mohammadrezasafaeian/thermal-bmc/scripts/twi_report.txt

=== TWI DEBUG DUMP REPORT (paste this whole block) ===
dbg_head: NOT PROVIDED
status bytes: 1   frames: 1   ring overflows('!'): 0
RST banners: 0  

-- status histogram --
  0xB3 x1     UNKNOWN CODE

-- frame classification --
  OTHER            x1

-- first 12 frames verbatim --
  [B3]  OTHER

-- auto-verdict (heuristic, confirm with tutor) --
  Mixed/partial pattern - send full report for analysis.
=== END REPORT ===
