mohammadrezasafaeian/thermal-bmc/docs/sim_run_mechanism.png

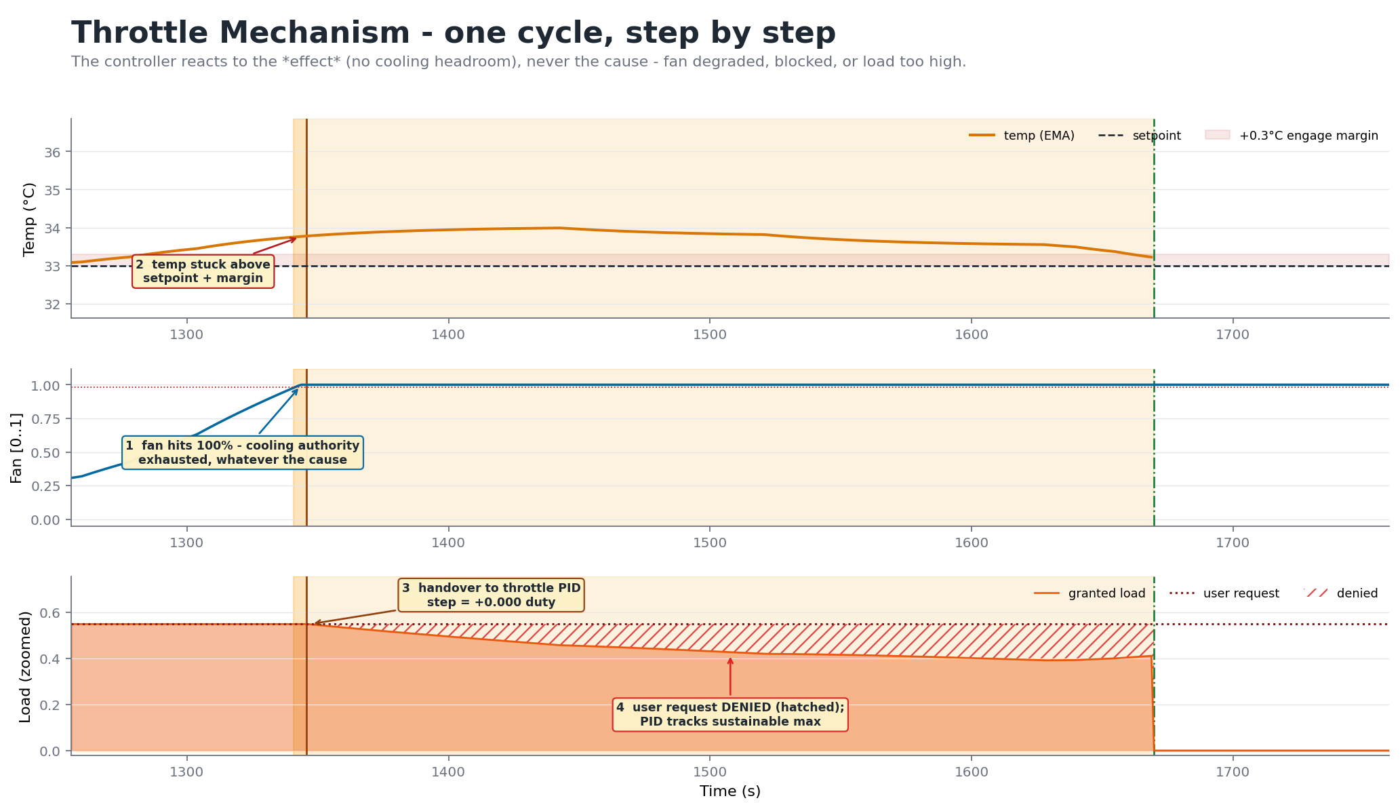
docs/sim_run_mechanism.png
