mohammadrezasafaeian/thermal-bmc/scripts/run1.png

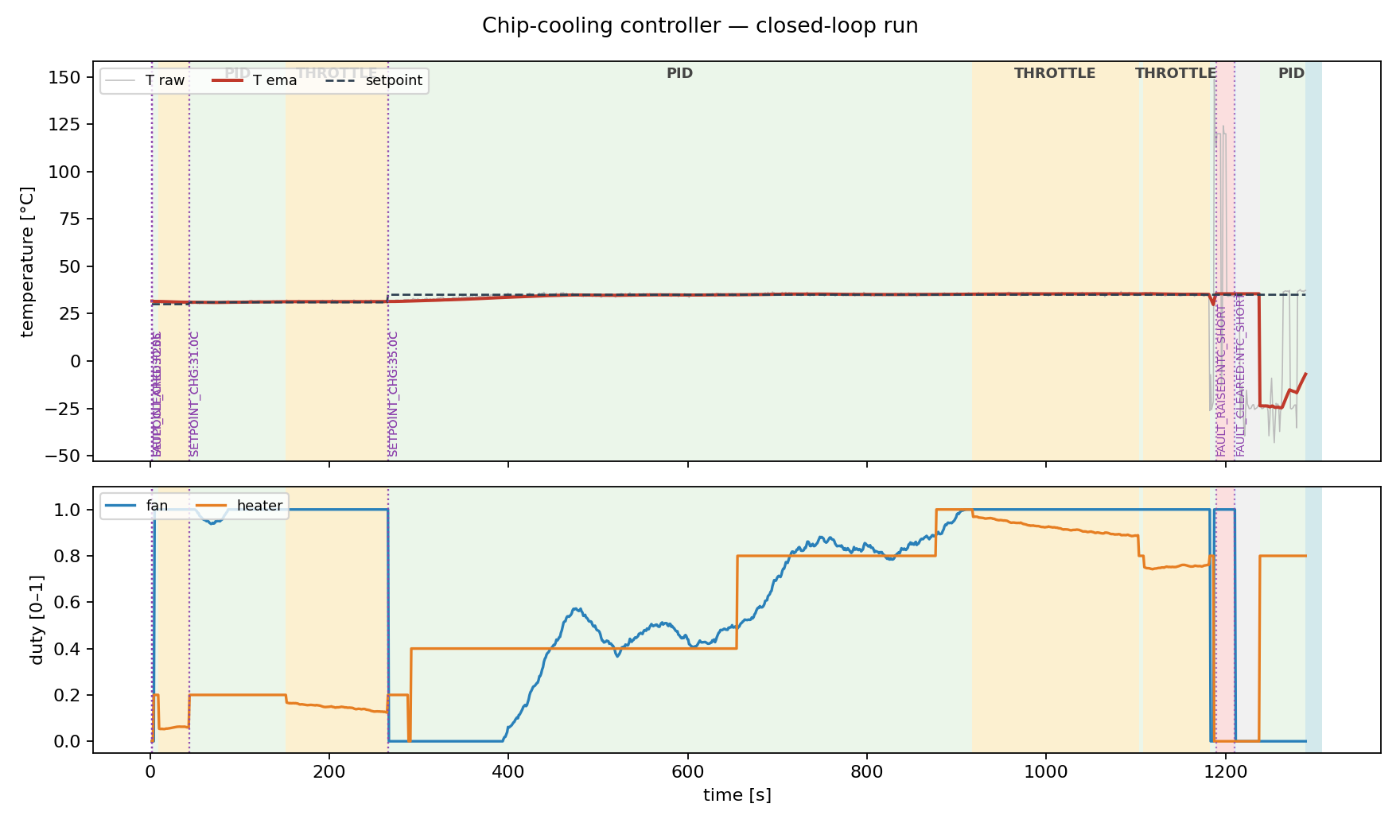
scripts/run1.png
