mohammadrezasafaeian/thermal-bmc/scripts/run1_walkthrough.png

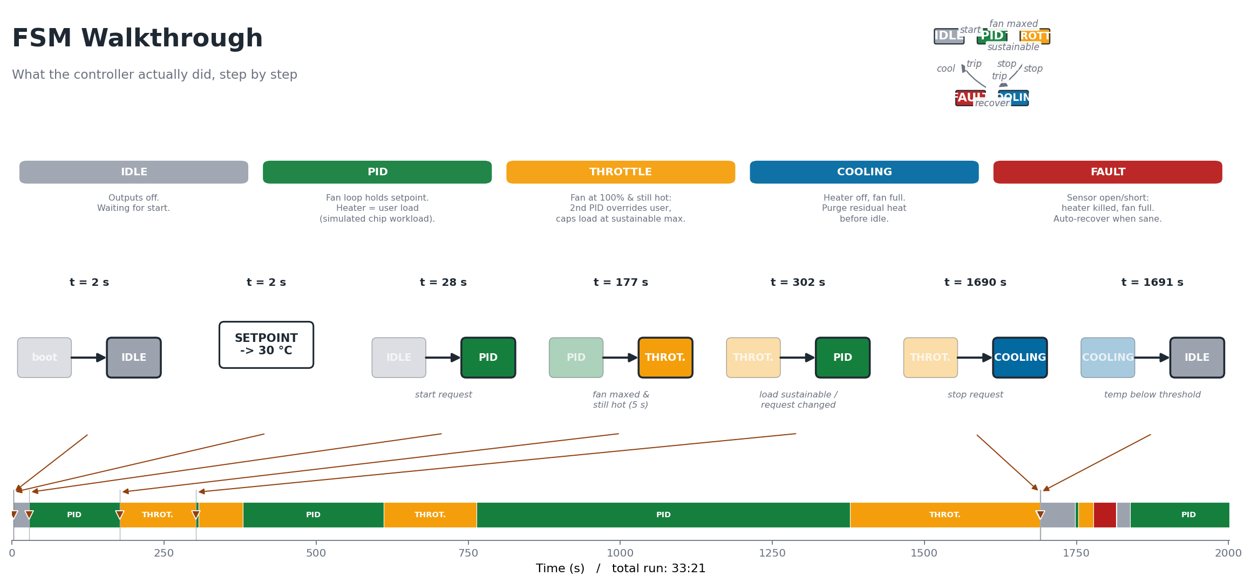
scripts/run1_walkthrough.png
