mohammadrezasafaeian/thermal-bmc/scripts/thermal_bidirectional.png

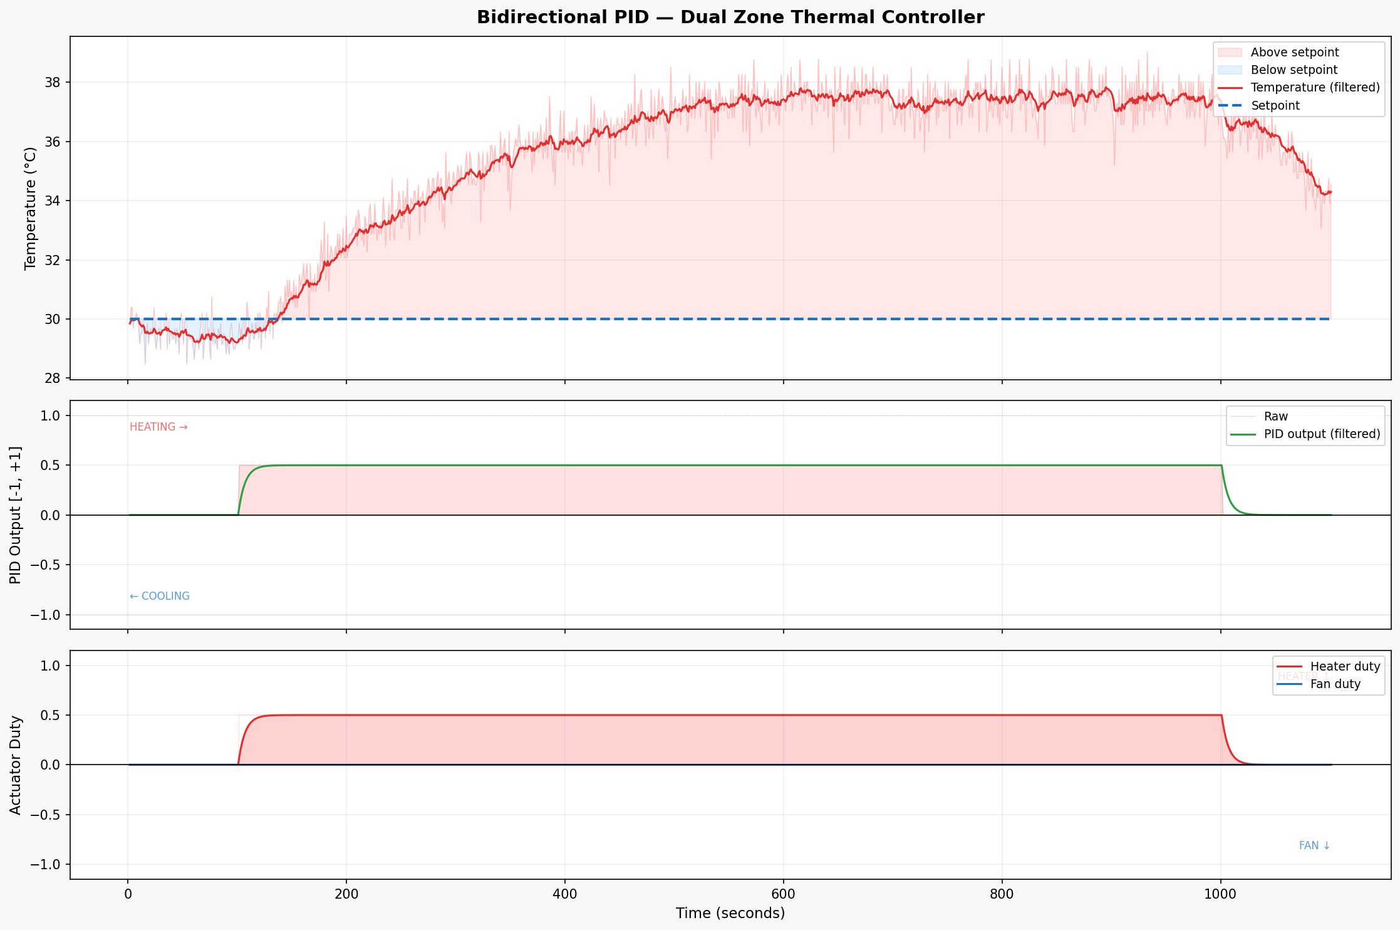
scripts/thermal_bidirectional.png
