mohammadrezasafaeian/thermal-bmc/scripts/step_test_01.txt

Name : thermal_log
	Details:{{time_s = 1.96400011, temp_c = 21.607605, setpoint_c = 30, heater_duty = 0.830414534, fan_duty = 0}, {time_s = 2.97100019, temp_c = 23.1402588, setpoint_c = 30, heater_duty = 0.834197402, fan_duty = 0}, {time_s = 3.97800016, temp_c = 23.8107605, setpoint_c = 30, heater_duty = 0.836668134, 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
	Default:0x20000848 <thermal_log>
	Decimal:536873032
	Hex:0x20000848
	Binary:100000000000000000100001001000
	Octal:04000004110

Name : [0...99]
	Details:{{time_s = 1.96400011, temp_c = 21.607605, setpoint_c = 30, heater_duty = 0.830414534, fan_duty = 0}, {time_s = 2.97100019, temp_c = 23.1402588, setpoint_c = 30, heater_duty = 0.834197402, fan_duty = 0}, {time_s = 3.97800016, temp_c = 23.8107605, setpoint_c = 30, heater_duty = 0.836668134, fan_duty = 0}, {time_s = 4.98500013, temp_c = 23.9472961, setpoint_c = 30, heater_duty = 0.838914156, fan_duty = 0}, {time_s = 5.95400047, temp_c = 24.2227783, setpoint_c = 30, heater_duty = 0.840659082, fan_duty = 0}, {time_s = 6.96100044, temp_c = 24.3618164, setpoint_c = 30, heater_duty = 0.842182279, fan_duty = 0}, {time_s = 7.96900034, temp_c = 24.0846252, setpoint_c = 30, heater_duty = 0.844321847, fan_duty = 0}, {time_s = 8.97700024, temp_c = 22.6177368, setpoint_c = 30, heater_duty = 0.849458754, fan_duty = 0}, {time_s = 9.98500061, temp_c = 22.7472229, setpoint_c = 30, heater_duty = 0.854351103, fan_duty = 0}, {time_s = 10.9550009, temp_c = 23.0084839, setpoint_c = 30, heater_duty = 0.858736992, fan_duty = 0}, {time_s = 11.9630003, temp_c = 23.8107605, setpoint_c = 30, heater_duty = 0.861536026, fan_duty = 0}, {time_s = 12.9720011, temp_c = 24.6424255, setpoint_c = 30, heater_duty = 0.862708151, fan_duty = 0}, {time_s = 13.9810009, temp_c = 23.0084839, setpoint_c = 30, heater_duty = 0.867223501, fan_duty = 0}, {time_s = 14.9900007, temp_c = 22.4889526, setpoint_c = 30, heater_duty = 0.872803688, fan_duty = 0}, {time_s = 15.960001, temp_c = 24.0846252, setpoint_c = 30, heater_duty = 0.875188231, fan_duty = 0}, {time_s = 16.9700012, temp_c = 23.9472961, setpoint_c = 30, heater_duty = 0.877895594, fan_duty = 0}, {time_s = 17.9790001, temp_c = 22.7472229, setpoint_c = 20, heater_duty = -0.120944716, fan_duty = 0}, {time_s = 18.9880009, temp_c = 22.3609314, setpoint_c = 20, heater_duty = -0.122996487, fan_duty = 0.120944716}, {time_s = 19.9590015, temp_c = 22.4889526, setpoint_c = 20, heater_duty = -0.125302047, fan_duty = 0.122996487}, {time_s = 20.9690018, temp_c = 21.361969, setpoint_c = 20, heater_duty = -0.125338316, fan_duty = 0.125302047}, {time_s = 21.9790001, temp_c = 22.2336121, setpoint_c = 20, heater_duty = -0.127145961, fan_duty = 0.125338316}, {time_s = 22.9890003, temp_c = 21.607605, setpoint_c = 20, heater_duty = -0.127696112, fan_duty = 0.127145961}, {time_s = 23.9610004, temp_c = 21.361969, setpoint_c = 20, heater_duty = -0.127767742, fan_duty = 0.127696112}, {time_s = 24.972002, temp_c = 22.6177368, setpoint_c = 20, heater_duty = -0.130381227, fan_duty = 0.127767742}, {time_s = 25.9820004, temp_c = 21.118988, setpoint_c = 20, heater_duty = -0.129974976, fan_duty = 0.130381227}, {time_s = 26.9540005, temp_c = 22.7472229, setpoint_c = 20, heater_duty = -0.132864207, fan_duty = 0.129974976}, {time_s = 27.9660015, temp_c = 21.484436, setpoint_c = 20, heater_duty = -0.133204013, fan_duty = 0.132864207}, {time_s = 28.9770012, temp_c = 22.2336121, setpoint_c = 20, heater_duty = -0.135065109, fan_duty = 0.133204013}, {time_s = 29.9880009, temp_c = 21.361969, setpoint_c = 20, heater_duty = -0.135174438, fan_duty = 0.135065109}, {time_s = 30.9610023, temp_c = 21.855896, setpoint_c = 20, heater_duty = -0.136295095, fan_duty = 0.135174438}, {time_s = 31.9730015, temp_c = 21.9811096, setpoint_c = 23, heater_duty = 0.163525581, fan_duty = 0.136295095}, {time_s = 32.9850006, temp_c = 21.484436, setpoint_c = 23, heater_duty = 0.165539399, fan_duty = 0}, {time_s = 33.9580002, temp_c = 22.4889526, setpoint_c = 23, heater_duty = 0.165520161, fan_duty = 0}, {time_s = 34.9700012, temp_c = 21.607605, setpoint_c = 23, heater_duty = 0.167279243, fan_duty = 0}, {time_s = 35.9830017, temp_c = 21.484436, setpoint_c = 23, heater_duty = 0.169272661, fan_duty = 0}, {time_s = 36.9570007, temp_c = 22.8774719, setpoint_c = 23, heater_duty = 0.168453351, fan_duty = 0}, {time_s = 37.9700012, temp_c = 21.7314148, setpoint_c = 23, heater_duty = 0.16995357, fan_duty = 0}, {time_s = 38.9830017, temp_c = 21.484436, setpoint_c = 23, heater_duty = 0.171940103, fan_duty = 0}, {time_s = 39.9570007, temp_c = 22.6177368, setpoint_c = 23, heater_duty = 0.171635479, fan_duty = 0}, {time_s = 40.9710007, temp_c = 22.4889526, setpoint_c = 23, heater_duty = 0.171601593, fan_duty = 0}, {time_s = 41.9840012, temp_c = 21.484436, setpoint_c = 23, heater_duty = 0.173593611, fan_duty = 0}, {time_s = 42.9590034, temp_c = 21.607605, setpoint_c = 23, heater_duty = 0.175322711, fan_duty = 0}, {time_s = 43.9730034, temp_c = 21.7314148, setpoint_c = 23, heater_duty = 0.176790893, fan_duty = 0}, {time_s = 44.9870033, temp_c = 21.361969, setpoint_c = 23, heater_duty = 0.178991824, fan_duty = 0}, {time_s = 45.9630013, temp_c = 22.3609314, setpoint_c = 23, heater_duty = 0.179169118, fan_duty = 0}, {time_s = 46.9770012, temp_c = 22.3609314, setpoint_c = 23, heater_duty = 0.179353088, fan_duty = 0}, {time_s = 47.9530029, temp_c = 22.4889526, setpoint_c = 23, heater_duty = 0.179286465, fan_duty = 0}, {time_s = 48.9680023, temp_c = 22.8774719, setpoint_c = 23, heater_duty = 0.178449273, fan_duty = 0}, {time_s = 49.9830017, temp_c = 22.2336121, setpoint_c = 23, heater_duty = 0.178923711, fan_duty = 0}, {time_s = 50.9590034, temp_c = 21.361969, setpoint_c = 23, heater_duty = 0.181151196, fan_duty = 0}, {time_s = 51.9750023, temp_c = 21.607605, setpoint_c = 23, heater_duty = 0.18286708, fan_duty = 0}, {time_s = 52.9900017, temp_c = 21.484436, setpoint_c = 23, heater_duty = 0.184818238, fan_duty = 0}, {time_s = 53.9670029, temp_c = 22.2336121, setpoint_c = 23, heater_duty = 0.185250282, fan_duty = 0}, {time_s = 54.9830017, temp_c = 22.7472229, setpoint_c = 23, heater_duty = 0.184654623, fan_duty = 0}, {time_s = 55.9600029, temp_c = 23.1402588, setpoint_c = 23, heater_duty = 0.183285683, fan_duty = 0}, {time_s = 56.9770012, temp_c = 21.7314148, setpoint_c = 23, heater_duty = 0.184770823, fan_duty = 0}, {time_s = 57.9540024, temp_c = 21.484436, setpoint_c = 23, heater_duty = 0.18674247, fan_duty = 0}, {time_s = 58.9710045, temp_c = 22.6177368, setpoint_c = 23, heater_duty = 0.186423331, fan_duty = 0}, {time_s = 59.9880028, temp_c = 21.855896, setpoint_c = 23, heater_duty = 0.187646478, fan_duty = 0}, {time_s = 60.9660034, temp_c = 21.361969, setpoint_c = 23, heater_duty = 0.189855114, fan_duty = 0}, {time_s = 61.9830017, temp_c = 22.7472229, setpoint_c = 23, heater_duty = 0.189264268, fan_duty = 0}, {time_s = 62.9620018, temp_c = 21.9811096, setpoint_c = 23, heater_duty = 0.190227658, fan_duty = 0}, {time_s = 63.9800034, temp_c = 21.484436, setpoint_c = 23, heater_duty = 0.192185342, fan_duty = 0}, {time_s = 64.9580002, temp_c = 22.8774719, setpoint_c = 23, heater_duty = 0.191330999, fan_duty = 0}, {time_s = 65.9760056, temp_c = 21.7314148, setpoint_c = 23, heater_duty = 0.192796856, fan_duty = 0}, {time_s = 66.9560013, temp_c = 22.6177368, setpoint_c = 23, heater_duty = 0.192473978, fan_duty = 0}, {time_s = 67.9570007, temp_c = 22.1070251, setpoint_c = 23, heater_duty = 0.193189308, fan_duty = 0}, {time_s = 68.9580002, temp_c = 21.484436, setpoint_c = 23, heater_duty = 0.195154741, fan_duty = 0}, {time_s = 69.9589996, temp_c = 22.7472229, setpoint_c = 23, heater_duty = 0.194569439, fan_duty = 0}, {time_s = 70.9610062, temp_c = 21.9811096, setpoint_c = 23, heater_duty = 0.195538253, fan_duty = 0}, {time_s = 71.9630051, temp_c = 22.4889526, setpoint_c = 23, heater_duty = 0.195484191, fan_duty = 0}, {time_s = 72.965004, temp_c = 21.855896, setpoint_c = 23, heater_duty = 0.196710497, fan_duty = 0}, {time_s = 73.9670029, temp_c = 22.2336121, setpoint_c = 23, heater_duty = 0.197172254, fan_duty = 0}, {time_s = 74.9690018, temp_c = 22.6177368, setpoint_c = 23, heater_duty = 0.196865618, fan_duty = 0}, {time_s = 75.9710007, temp_c = 21.855896, setpoint_c = 23, heater_duty = 0.198101044, fan_duty = 0}, {time_s = 76.9740067, temp_c = 23.0084839, setpoint_c = 23, heater_duty = 0.197015733, fan_duty = 0}, {time_s = 77.977005, temp_c = 21.7314148, setpoint_c = 23, heater_duty = 0.198516309, fan_duty = 0}, {time_s = 78.9800034, temp_c = 22.8774719, setpoint_c = 23, heater_duty = 0.197705805, fan_duty = 0}, {time_s = 79.9830017, temp_c = 21.607605, setpoint_c = 23, heater_duty = 0.199463487, fan_duty = 0}, {time_s = 80.9870071, temp_c = 22.8774719, setpoint_c = 23, heater_duty = 0.198658288, fan_duty = 0}, {time_s = 81.9520035, temp_c = 21.7314148, setpoint_c = 23, heater_duty = 0.200172424, fan_duty = 0}, {time_s = 82.9560013, temp_c = 23.5401611, setpoint_c = 23, heater_duty = 0.198044747, fan_duty = 0}, {time_s = 83.9600067, temp_c = 21.607605, setpoint_c = 23, heater_duty = 0.199831426, fan_duty = 0}, {time_s = 84.9640045, temp_c = 21.7314148, setpoint_c = 23, heater_duty = 0.201356038, fan_duty = 0}, {time_s = 85.9680023, temp_c = 22.6177368, setpoint_c = 23, heater_duty = 0.201090783, fan_duty = 0}, {time_s = 86.9730072, temp_c = 21.855896, setpoint_c = 23, heater_duty = 0.202366799, fan_duty = 0}, {time_s = 87.9780045, temp_c = 22.7472229, setpoint_c = 23, heater_duty = 0.20184578, fan_duty = 0}, {time_s = 88.9830017, temp_c = 21.9811096, setpoint_c = 23, heater_duty = 0.202877611, fan_duty = 0}, {time_s = 89.9880066, temp_c = 21.855896, setpoint_c = 23, heater_duty = 0.204156488, fan_duty = 0}, {time_s = 90.9540024, temp_c = 22.4889526, setpoint_c = 23, heater_duty = 0.204156935, fan_duty = 0}, {time_s = 91.9600067, temp_c = 23.0084839, setpoint_c = 23, heater_duty = 0.203122303, fan_duty = 0}, {time_s = 92.965004, temp_c = 21.361969, setpoint_c = 23, heater_duty = 0.20541434, fan_duty = 0}, {time_s = 93.9710007, temp_c = 21.855896, setpoint_c = 23, heater_duty = 0.206695065, fan_duty = 0}, {time_s = 94.977005, temp_c = 22.4889526, setpoint_c = 23, heater_duty = 0.206697211, fan_duty = 0}, {time_s = 95.9830017, temp_c = 22.7472229, setpoint_c = 23, heater_duty = 0.206188992, fan_duty = 0}, {time_s = 96.989006, temp_c = 22.2336121, setpoint_c = 23, heater_duty = 0.206726313, fan_duty = 0}, {time_s = 97.9570084, temp_c = 21.607605, setpoint_c = 23, heater_duty = 0.208522141, fan_duty = 0}, {time_s = 98.9630051, temp_c = 21.7314148, setpoint_c = 23, heater_duty = 0.210055619, fan_duty = 0}, {time_s = 99.9700012, temp_c = 21.9811096, setpoint_c = 23, heater_duty = 0.211077392, fan_duty = 0}, {time_s = 100.977005, temp_c = 21.855896, setpoint_c = 23, heater_duty = 0.212346464, fan_duty = 0}}
	Default:0x20000848 <thermal_log>
	Decimal:536873032
	Hex:0x20000848
	Binary:100000000000000000100001001000
	Octal:04000004110

Name : [600...699]
	Details:{{time_s = 601.980042, temp_c = 32.0738831, setpoint_c = 30, heater_duty = 0.691611528, fan_duty = 0}, {time_s = 602.968018, temp_c = 29.8485107, setpoint_c = 30, heater_duty = 0.692763627, fan_duty = 0}, {time_s = 603.957031, temp_c = 30.385376, setpoint_c = 30, heater_duty = 0.692816973, 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
	Default:0x20003728 <thermal_log+12000>
	Decimal:536885032
	Hex:0x20003728
	Binary:100000000000000011011100101000
	Octal:04000033450

Name : [100...199]
	Details:{{time_s = 101.984001, temp_c = 22.4889526, setpoint_c = 23, heater_duty = 0.212337375, fan_duty = 0}, {time_s = 102.952003, temp_c = 22.2336121, setpoint_c = 23, heater_duty = 0.212849349, fan_duty = 0}, {time_s = 103.960007, temp_c = 22.1070251, setpoint_c = 23, heater_duty = 0.213617563,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
	Default:0x20001018 <thermal_log+2000>
	Decimal:536875032
	Hex:0x20001018
	Binary:100000000000000001000000011000
	Octal:04000010030

Name : [300...399]
	Details:{{time_s = 301.971008, temp_c = 25.5055237, setpoint_c = 30, heater_duty = 0.999126792, fan_duty = 0}, {time_s = 302.959015, temp_c = 25.5055237, setpoint_c = 30, heater_duty = 1, fan_duty = 0}, {time_s = 303.987, temp_c = 26.7093811, setpoint_c = 30, heater_duty = 0.996566057, fan_duty = 0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
	Default:0x20001fb8 <thermal_log+6000>
	Decimal:536879032
	Hex:0x20001fb8
	Binary:100000000000000001111110111000
	Octal:04000017670

Name : [200...299]
	Details:{{time_s = 201.972015, temp_c = 22.4889526, setpoint_c = 23, heater_duty = 0.215622678, fan_duty = 0}, {time_s = 202.961014, temp_c = 23.1402588, setpoint_c = 23, heater_duty = 0.214917526, fan_duty = 0}, {time_s = 203.990005, temp_c = 23.5401611, setpoint_c = 23, heater_duty = 0.213421121,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
	Default:0x200017e8 <thermal_log+4000>
	Decimal:536877032
	Hex:0x200017e8
	Binary:100000000000000001011111101000
	Octal:04000013750

Name : [400...499]
	Details:{{time_s = 401.966034, temp_c = 28.4746094, setpoint_c = 30, heater_duty = 0.940233052, fan_duty = 0}, {time_s = 402.95401, temp_c = 30.385376, setpoint_c = 30, heater_duty = 0.936831951, fan_duty = 0}, {time_s = 403.981018, temp_c = 28.8105469, setpoint_c = 30, heater_duty = 0.936655104, f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
	Default:0x20002788 <thermal_log+8000>
	Decimal:536881032
	Hex:0x20002788
	Binary:100000000000000010011110001000
	Octal:04000023610

Name : [500...599]
	Details:{{time_s = 501.97403, temp_c = 30.2050476, setpoint_c = 30, heater_duty = 0.801114559, fan_duty = 0}, {time_s = 502.962036, temp_c = 30.2050476, setpoint_c = 30, heater_duty = 0.800677776, fan_duty = 0}, {time_s = 503.989014, temp_c = 31.8801575, setpoint_c = 30, heater_duty = 0.796882629, 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
	Default:0x20002f58 <thermal_log+10000>
	Decimal:536883032
	Hex:0x20002f58
	Binary:100000000000000010111101011000
	Octal:04000027530

Name : [700...799]
	Details:{{time_s = 701.983032, temp_c = 30.2050476, setpoint_c = 30, heater_duty = 0.647999525, fan_duty = 0}, {time_s = 702.955017, temp_c = 29.323761, setpoint_c = 30, heater_duty = 0.650060594, fan_duty = 0}, {time_s = 703.966003, temp_c = 30.2050476, setpoint_c = 30, heater_duty = 0.650321662, 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
	Default:0x20003ef8 <thermal_log+14000>
	Decimal:536887032
	Hex:0x20003ef8
	Binary:100000000000000011111011111000
	Octal:04000037370

Name : [800...899]
	Details:{{time_s = 800.221008, temp_c = 29.6723022, setpoint_c = 30, heater_duty = 0.647840202, fan_duty = 0}, {time_s = 801.232056, temp_c = 30.2050476, setpoint_c = 30, heater_duty = 0.647747219, fan_duty = 0}, {time_s = 802.203064, temp_c = 28.8105469, setpoint_c = 30, heater_duty = 0.650453091,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
	Default:0x200046c8 <thermal_log+16000>
	Decimal:536889032
	Hex:0x200046c8
	Binary:100000000000000100011011001000
	Octal:04000043310

Name : [900...999]
	Details:{{time_s = 900.21405, temp_c = 29.1514282, setpoint_c = 30, heater_duty = 0.655790687, fan_duty = 0}, {time_s = 901.225037, temp_c = 30.2050476, setpoint_c = 30, heater_duty = 0.655443847, fan_duty = 0}, {time_s = 902.197021, temp_c = 29.323761, setpoint_c = 30, heater_duty = 0.656870186, f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
	Default:0x20004e98 <thermal_log+18000>
	Decimal:536891032
	Hex:0x20004e98
	Binary:100000000000000100111010011000
	Octal:04000047230
