mohammadrezasafaeian/thermal-bmc/scripts/step_test_01.png

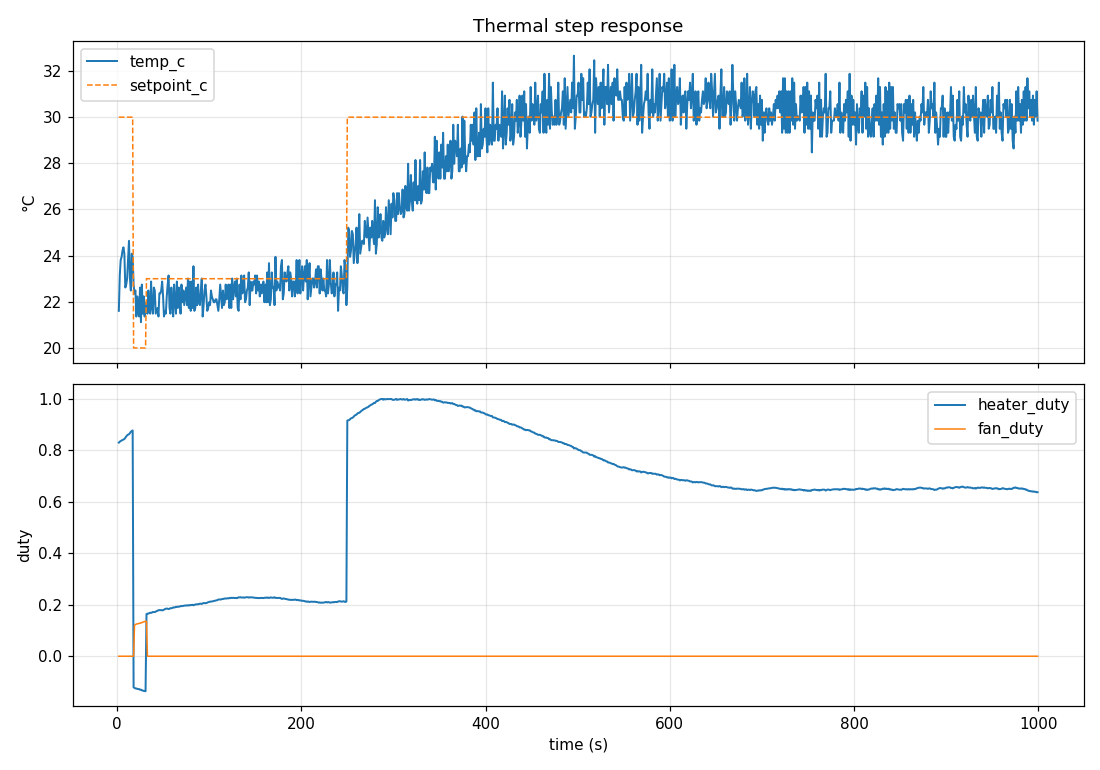
scripts/step_test_01.png
