mohammadrezasafaeian/thermal-bmc/scripts/step_test_01_pid.png

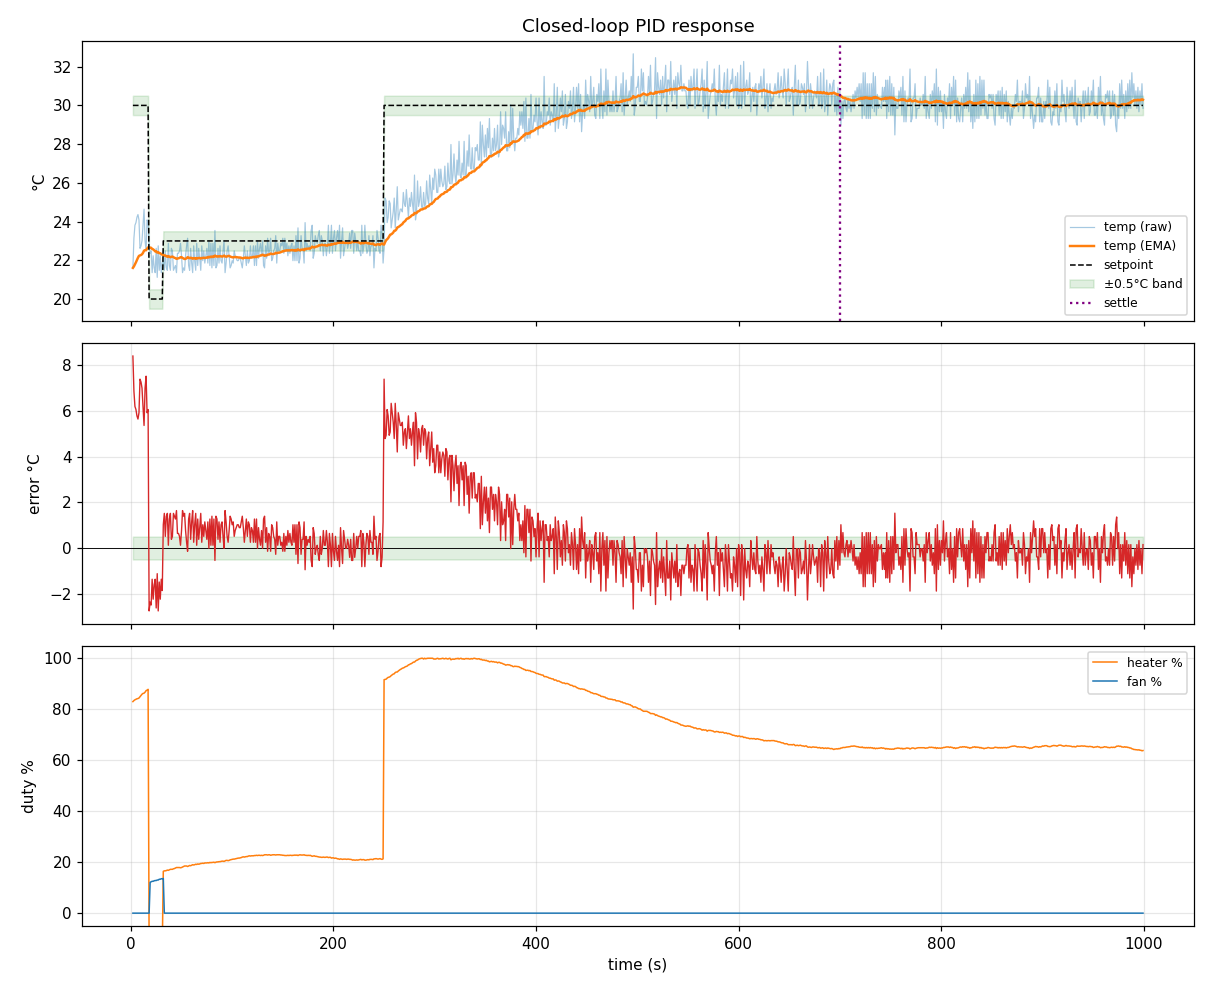
scripts/step_test_01_pid.png
