mohammadrezasafaeian/thermal-bmc/Core/Src/main.c

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
/* Includes ------------------------------------------------------------------*/
#include "main.h"
#include "cmsis_os.h"

/* USER CODE BEGIN Includes */
#include "ssd1306.h"
#include "thermal_app.h"
#include "cyc.h"
#include "FreeRTOS.h"
/* USER CODE END Includes */

ADC_HandleTypeDef hadc1;

I2C_HandleTypeDef hi2c1;

TIM_HandleTypeDef htim2;
TIM_HandleTypeDef htim3;
TIM_HandleTypeDef htim5;

UART_HandleTypeDef huart1;
UART_HandleTypeDef huart2;

osThreadId defaultTaskHandle;
/* USER CODE BEGIN PV */
extern volatile Profiler g_prof;

#define DBG_RING_SZ 256
volatile uint8_t  dbg_ring[DBG_RING_SZ];
volatile uint16_t dbg_head = 0;        /* watch these two in Live     */
uint8_t           dbg_rx_byte;         /* Expressions / Live Watch
/* USER CODE END PV */

void SystemClock_Config(void);
static void MX_GPIO_Init(void);
static void MX_USART2_UART_Init(void);
static void MX_I2C1_Init(void);
static void MX_ADC1_Init(void);
static void MX_TIM2_Init(void);
static void MX_TIM3_Init(void);
static void MX_TIM5_Init(void);
static void MX_USART1_UART_Init(void);
void StartDefaultTask(void const * argument);

/* USER CODE BEGIN 0 */

volatile uint32_t g_tach_pulses = 0;
/* USER CODE END 0 */

/**
  * @brief  The application entry point.
  * @retval int
  */
int main(void)
{

  /* MCU Configuration--------------------------------------------------------*/

  /* Reset of all peripherals, Initializes the Flash interface and the Systick. */
  HAL_Init();

  /* Configure the system clock */
  SystemClock_Config();

  /* Initialize all configured peripherals */
  MX_GPIO_Init();
  MX_USART2_UART_Init();
  MX_I2C1_Init();
  MX_ADC1_Init();
  MX_TIM2_Init();
  MX_TIM3_Init();
  MX_TIM5_Init();
  MX_USART1_UART_Init();
  HAL_UART_Receive_IT(&huart1, &dbg_rx_byte, 1);
  /* USER CODE BEGIN 2 */

  ssd1306_init();     /* Initialise OLED driver                          */
  ThermalApp_Init();  /* Start PWM, zero buffers, display splash screen  */
  /* USER CODE END 2 */

  /* USER CODE BEGIN RTOS_MUTEX */
  /* add mutexes, ... */
  /* USER CODE END RTOS_MUTEX */

  /* USER CODE BEGIN RTOS_SEMAPHORES */
  /* add semaphores, ... */
  /* USER CODE END RTOS_SEMAPHORES */

  /* USER CODE BEGIN RTOS_TIMERS */
  /* start timers, add new ones, ... */
  /* USER CODE END RTOS_TIMERS */

  /* USER CODE BEGIN RTOS_QUEUES */
  /* add queues, ... */
  /* USER CODE END RTOS_QUEUES */

  /* Create the thread(s) */
  /* definition and creation of defaultTask */
  osThreadDef(defaultTask, StartDefaultTask, osPriorityNormal, 0, 512);
  defaultTaskHandle = osThreadCreate(osThread(defaultTask), NULL);

  /* USER CODE BEGIN RTOS_THREADS */

  ThermalApp_StartTasks();
  /* USER CODE END RTOS_THREADS */

  /* Start scheduler */
  osKernelStart();

  /* We should never get here as control is now taken by the scheduler */

  /* Infinite loop */
  /* USER CODE BEGIN WHILE */
  while (1)
  {
    /* USER CODE END WHILE */

    /* USER CODE BEGIN 3 */

  }
  /* USER CODE END 3 */
}

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
/* USER CODE BEGIN 4 */
/*
 * NOTE: HAL_TIM_PeriodElapsedCallback intentionally NOT defined here.
 * The single dispatcher lives in the CubeMX-generated callback below;
 * our TIM2 branch is inside its USER CODE Callback 1 section so it
 * survives code regeneration. A second definition here = link error.
 */
void HAL_GPIO_EXTI_Callback(uint16_t GPIO_Pin)
{
    if (GPIO_Pin == GPIO_PIN_9) {
        g_tach_pulses++;
    }
}

void HAL_UART_RxCpltCallback(UART_HandleTypeDef *huart)
{
    if (huart->Instance == USART1) {
        dbg_ring[dbg_head % DBG_RING_SZ] = dbg_rx_byte;
        dbg_head++;
        HAL_UART_Receive_IT(&huart1, &dbg_rx_byte, 1);
    }
}
/* USER CODE END 4 */

/* USER CODE BEGIN Header_StartDefaultTask */
/**
  * @brief  Function implementing the defaultTask thread.
  * @param  argument: Not used
  * @retval None
  */
/* USER CODE END Header_StartDefaultTask */
void StartDefaultTask(void const * argument)
{
  /* USER CODE BEGIN 5 */
  /* Infinite loop */
  for(;;)
  {
    osDelay(1);
  }
  /* USER CODE END 5 */
}

/**
  * @brief  Period elapsed callback in non blocking mode
  * @note   This function is called  when TIM11 interrupt took place, inside
  * HAL_TIM_IRQHandler(). It makes a direct call to HAL_IncTick() to increment
  * a global variable "uwTick" used as application time base.
  * @param  htim : TIM handle
  * @retval None
  */
void HAL_TIM_PeriodElapsedCallback(TIM_HandleTypeDef *htim)
{
  if (htim->Instance == TIM11)
  {
    HAL_IncTick();
  }
  /* USER CODE BEGIN Callback 1 */
  else if (htim->Instance == TIM2) {   /* 1 Hz control tick -> queue event */
    ThermalApp_TickISR();
  }
  /* USER CODE END Callback 1 */
}

/**
  * @brief  This function is executed in case of error occurrence.
  * @retval None
  */
void Error_Handler(void)
{
  /* USER CODE BEGIN Error_Handler_Debug */
  __disable_irq();
  while (1)
  {
    /* Spin here; attach a debugger and inspect the call stack. */
  }
  /* USER CODE END Error_Handler_Debug */
}
#ifdef USE_FULL_ASSERT
/**
  * @brief  Reports the name of the source file and the source line number
  *         where the assert_param error has occurred.
  * @param  file: pointer to the source file name
  * @param  line: assert_param error line source number
  * @retval None
  */
void assert_failed(uint8_t *file, uint32_t line)
{
  /* USER CODE BEGIN 6 */
  /* Example: printf("Wrong parameter: file %s, line %d\r\n", file, line); */
  (void)file;
  (void)line;
  /* USER CODE END 6 */
}
#endif /* USE_FULL_ASSERT */
