mohammadrezasafaeian/thermal-bmc/Thermistor.ioc

Mcu.UserName=STM32F411CEUx
PA0-WKUP.Signal=ADCx_IN0
PA1.Signal=S_TIM5_CH2
PA10.Signal=USART1_RX
PA2.Signal=USART2_TX
PA3.Signal=USART2_RX
PA4.Signal=GPIO_Output
PA5.Signal=GPIO_Output
PA6.Signal=S_TIM3_CH1
PA7.Signal=S_TIM3_CH2
PA9.Signal=USART1_TX
PB12.Signal=GPIO_Output
PB4.Signal=GPIO_Output
PB6.Signal=I2C1_SCL
PB7.Signal=I2C1_SDA
PB8.Signal=GPIO_Output
PB9.Signal=GPXTI9
