mohammadrezasafaeian/thermal-bmc/scripts/thermal_dump.txt

Name : thermal_log
	Details:{{time_s = 1.96400011, temp_c = 29.8485107, setpoint_c = 30, heater_duty = 0, fan_duty = 0}, {time_s = 2.9690001, temp_c = 30.385376, setpoint_c = 30, heater_duty = 0, fan_duty = 0}, {time_s = 3.97500014, temp_c = 30.385376, setpoint_c = 30, heater_duty = 0, fan_duty = 0}, {time_s = 4.98200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
	Default:0x20000848 <thermal_log>
	Decimal:536873032
	Hex:0x20000848
	Binary:100000000000000000100001001000
	Octal:04000004110

Name : [400...499]
	Details:{{time_s = 401.956024, temp_c = 36.0915527, setpoint_c = 30, heater_duty = 0.5, fan_duty = 0}, {time_s = 402.984009, temp_c = 35.4104309, setpoint_c = 30, heater_duty = 0.5, fan_duty = 0}, {time_s = 403.973022, temp_c = 36.322998, setpoint_c = 30, heater_duty = 0.5, fan_duty = 0}, {time_s =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
	Default:0x20002788 <thermal_log+8000>
	Decimal:536881032
	Hex:0x20002788
	Binary:100000000000000010011110001000
	Octal:04000023610

Name : [0...99]
	Details:{{time_s = 1.96400011, temp_c = 29.8485107, setpoint_c = 30, heater_duty = 0, fan_duty = 0}, {time_s = 2.9690001, temp_c = 30.385376, setpoint_c = 30, heater_duty = 0, fan_duty = 0}, {time_s = 3.97500014, temp_c = 30.385376, setpoint_c = 30, heater_duty = 0, fan_duty = 0}, {time_s = 4.98200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
	Default:0x20000848 <thermal_log>
	Decimal:536873032
	Hex:0x20000848
	Binary:100000000000000000100001001000
	Octal:04000004110

Name : [100...199]
	Details:{{time_s = 101.977005, temp_c = 29.8485107, setpoint_c = 30, heater_duty = 0.5, fan_duty = 0}, {time_s = 102.983002, temp_c = 29.323761, setpoint_c = 30, heater_duty = 0.5, fan_duty = 0}, {time_s = 103.990005, temp_c = 29.6723022, setpoint_c = 30, heater_duty = 0.5, fan_duty = 0}, {time_s =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
	Default:0x20001018 <thermal_log+2000>
	Decimal:536875032
	Hex:0x20001018
	Binary:100000000000000001000000011000
	Octal:04000010030

Name : [200...299]
	Details:{{time_s = 201.983017, temp_c = 32.466156, setpoint_c = 30, heater_duty = 0.5, fan_duty = 0}, {time_s = 202.972015, temp_c = 32.8650818, setpoint_c = 30, heater_duty = 0.5, fan_duty = 0}, {time_s = 203.960007, temp_c = 32.8650818, setpoint_c = 30, heater_duty = 0.5, fan_duty = 0}, {time_s =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
	Default:0x200017e8 <thermal_log+4000>
	Decimal:536877032
	Hex:0x200017e8
	Binary:100000000000000001011111101000
	Octal:04000013750

Name : [300...399]
	Details:{{time_s = 301.962006, temp_c = 35.1876221, setpoint_c = 30, heater_duty = 0.5, fan_duty = 0}, {time_s = 302.990021, temp_c = 34.9668579, setpoint_c = 30, heater_duty = 0.5, fan_duty = 0}, {time_s = 303.979004, temp_c = 34.5314026, setpoint_c = 30, heater_duty = 0.5, fan_duty = 0}, {time_s 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
	Default:0x20001fb8 <thermal_log+6000>
	Decimal:536879032
	Hex:0x20001fb8
	Binary:100000000000000001111110111000
	Octal:04000017670

Name : [500...599]
	Details:{{time_s = 501.988037, temp_c = 37.0308838, setpoint_c = 30, heater_duty = 0.5, fan_duty = 0}, {time_s = 502.97702, temp_c = 36.7926025, setpoint_c = 30, heater_duty = 0.5, fan_duty = 0}, {time_s = 503.965027, temp_c = 37.2715454, setpoint_c = 30, heater_duty = 0.5, fan_duty = 0}, {time_s =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
	Default:0x20002f58 <thermal_log+10000>
	Decimal:536883032
	Hex:0x20002f58
	Binary:100000000000000010111101011000
	Octal:04000027530

Name : [600...699]
	Details:{{time_s = 601.972046, temp_c = 37.0308838, setpoint_c = 30, heater_duty = 0.5, fan_duty = 0}, {time_s = 602.960022, temp_c = 37.7601929, setpoint_c = 30, heater_duty = 0.5, fan_duty = 0}, {time_s = 603.988037, temp_c = 38.2589111, setpoint_c = 30, heater_duty = 0.5, fan_duty = 0}, {time_s 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
	Default:0x20003728 <thermal_log+12000>
	Decimal:536885032
	Hex:0x20003728
	Binary:100000000000000011011100101000
	Octal:04000033450

Name : [700...799]
	Details:{{time_s = 701.960022, temp_c = 36.5566406, setpoint_c = 30, heater_duty = 0.5, fan_duty = 0}, {time_s = 702.988037, temp_c = 37.2715454, setpoint_c = 30, heater_duty = 0.5, fan_duty = 0}, {time_s = 703.976013, temp_c = 36.7926025, setpoint_c = 30, heater_duty = 0.5, fan_duty = 0}, {time_s 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
	Default:0x20003ef8 <thermal_log+14000>
	Decimal:536887032
	Hex:0x20003ef8
	Binary:100000000000000011111011111000
	Octal:04000037370

Name : [800...899]
	Details:{{time_s = 801.968018, temp_c = 38.0082397, setpoint_c = 30, heater_duty = 0.5, fan_duty = 0}, {time_s = 802.979065, temp_c = 37.2715454, setpoint_c = 30, heater_duty = 0.5, fan_duty = 0}, {time_s = 803.990051, temp_c = 36.7926025, setpoint_c = 30, heater_duty = 0.5, fan_duty = 0}, {time_s 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
	Default:0x200046c8 <thermal_log+16000>
	Decimal:536889032
	Hex:0x200046c8
	Binary:100000000000000100011011001000
	Octal:04000043310

Name : [900...999]
	Details:{{time_s = 901.987061, temp_c = 36.5566406, setpoint_c = 30, heater_duty = 0.5, fan_duty = 0}, {time_s = 902.958069, temp_c = 35.1876221, setpoint_c = 30, heater_duty = 0.5, fan_duty = 0}, {time_s = 903.969055, temp_c = 36.7926025, setpoint_c = 30, heater_duty = 0.5, fan_duty = 0}, {time_s 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
	Default:0x20004e98 <thermal_log+18000>
	Decimal:536891032
	Hex:0x20004e98
	Binary:100000000000000100111010011000
	Octal:04000047230
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
