mohammadrezasafaeian/thermal-bmc/(commit log)

2026-05-28 feat: thermal controller with dual-PWM, EMA pre-filter, event-driven loop
2026-05-28 feat: bidirectional PID, output [-1,+1], heater/fan split
2026-05-28 feat: add Python analysis script with thermal dump parser
    [thermal_dump.txt]
2026-05-31 add FOPDT/SIMC extractor + fingerprint parser; plant ID K~17 tau~111 theta~10 -> Kp~0.11 Ki~0.0008
2026-06-01 closed-loop PID verified (Kp=0.10 Ki=0.0008); overshoot 11% matches phase-margin prediction; add response analyzer
2026-06-02 Rebuild ZoneCtrl FSM (IDLE/PID/COOLING done); voltage-based fault detect + debounce; ST_FAULT pending
2026-06-02 chore(scripts): remove obsolete plotter; add step-test capture artifacts
    [step_test.csv, step_test_01.csv, thermal_dump.txt]
2026-06-03 fix(thermal): freeze EMA outside PID state; clean boot event init
    [thermal_app.c, thermal_app.h]
2026-06-04 test(thermal): verified black-box log survives warm reset; cold-boot via magic mismatch confirmed
    [thermal_app.c]
2026-06-11 Phase 0: DWT profiling + hand-verified ring buffer rewrite
    - cyc.h: DWT_CYCCNT profiler (g_prof) - tick latency, ADC/OLED/ctrl costs in us
    - Baseline measured: ctrl work 91us; latency 5us..39.6ms (OLED+ADC collision)
    - ring_buf: SPSC rewrite - wrap-safe IsFull, store-before-publish ordering
    rationale documented, boot self-test
    - thermal_app: profiler hooks; open-loop path uses g_prof.tick_count
    - Header corrected: actual SYSCLK is 24 MHz (verified via PLL + TIM2 cross-check)
    [main.c, thermal_app.c]
2026-06-24 FreeRTOS skeleton builds
    - Enable FreeRTOS (CMSIS_V1, heap_4, 16KB)
    - HAL timebase -> TIM11, SysTick freed for kernel
    - TIM2 IRQ priority=5 (FromISR-safe)
    - Fix soft->hard float ABI (port.c context switch needs FPU)
    - Merge TIM callback (TIM11 HAL tick + TIM2 control tick)
    Known: app loop not in a task yet; control dead until wired in.
    [run1.csv]
2026-06-28 Migrate super-loop to FreeRTOS (ControlTask + UITask + queue)
    - ControlTask pri 3: blocks on queue, runs sense->FSM->PID->PWM
    - UITask pri 1: 10 Hz OLED, fault-isolated from control
    - TIM2 ISR posts via xQueueSendFromISR + portYIELD_FROM_ISR
    - Retired ring_buf polling + ThermalApp_Loop
    - Known: ADC1 shared (mutex next); fan PWM still 1kHz
2026-06-28 Add ADC mutex for shared ADC1 (Control + UI tasks)
    - xAdcMutex guards whole adc_average burst (atomic oversample)
    - skip lock before scheduler (guard via xTaskGetSchedulerState)
    - create mutex in StartTasks (pre-scheduler critical section safe there)
    [thermal_app.c]
2026-06-28 Move fan to TIM5_CH2 @ 24 kHz (PA1)
    - 4-wire fan PWM needs ~25 kHz (was buzzing at TIM3 1 kHz)
    - heater stays TIM3_CH1 @ 1 kHz (LM358 gate drive can't slew faster)
    - separate timers: heater and fan need different frequencies
    - pwm_update writes fan to htim5 CH2
    [Thermistor.ioc, main.c, thermal_app.c]
2026-06-29 Chip-cooling reframe: fan-PID + open-loop heater load
    - Two independent actuators: g_heater_duty (open-loop), g_fan_duty (PID)
    - Reverse-acting fan loop: negative gains, [0,1] clamp via out_min/out_max
    - SIMC retune Kp=-0.68 Ki=-0.0061 (pole-cancel tau_I=tau, lambda=10s)
    - FSM: COOLDOWN repurposed (post-stop), FAULT cuts heater + fan full
    - Log extended: +fan_duty, +heater_duty, +setpoint columns
    - Added minimal parse_run.py (CSV-only, decimated <=500 rows)
    TODO: restore full parse_struct_dump.py (figures/KPIs) once log schema settles
    TODO: .noinit attributes commented out (logs clear each boot) - revisit
    [run1.csv]
2026-06-30 feat: Mode C heater throttle (DVFS-style) — initial impl
    - heater open-loop duty was never throttled when fan saturated
    - add Mode C: fan saturated + still hot -> cut heater (fast cut/slow restore)
    - add mode_c_active flag, g_heater_request for user intent
    - heater follows request immediately when Mode C inactive
    - known limitation: open-loop cut/restore overshoots, replacing with PID next
    [thermal_app.c, thermal_app.h]
2026-07-02 Mode C throttle tier + FreeRTOS migration + cleanup
    - ST_THROTTLE: entry debounce, bumpless heater-PID handover, exit w/ hysteresis
    - RTOS: TIM2 tick->queue, ControlTask/UITask split, ADC mutex, TIM11 timebase
    - Fan PID SIMC-tuned (Kp=-0.68, Ki=-0.0061); PID generalized for either polarity
    - Regen-proof TIM2 dispatch inside generated HAL callback
    - Removed ring_buf, duplicate Profiler def, dead globals; verified on hardware
2026-07-02 feat(parser): restore old parser, rework into Mode-C story analyzer
    Restored from 9f71acb; 5-state FSM, mechanism figure w/ handover check, request-vs-granted, event-weighted CSVs
    [run1_events.csv, run1_old.csv, run1_old.csv.csv, run1_old_events.csv]
2026-07-05 fix(parser): honest handover metric, interp window bug, marks file
    [run1.csv, run1_events.csv]
2026-07-05 fix(modeC): corrected bumpless seed (subtract Kp*e) verified on hardware
    [thermal_app.c]
2026-07-11 feat: EXTI fan tachometer, Mode C stability, and datalog upgrades
    - Implemented zero-overhead EXTI pulse counting on PB9 for 4-wire fan tachometer.
    - Added FR_FAN_OPEN fault detection (< 300 RPM) using existing FSM inertia debounce.
    - Fixed Mode C oscillation chatter by adding a temperature recovery requirement to the exit condition.
    - Added heater_req and fan_rpm natively to the 1Hz FreeRTOS ring buffer.
    - Upgraded Python parser for twin-axis RPM plotting, dynamic fault panels, and accurate Mode C hatching.
    [Thermistor.ioc, main.c, thermal_app.c, thermal_app.h]
2026-07-13 feat: I2C Master architecture and shared memory
    - Defined I2C_Telemetry and I2C_Command data contracts for ATmega remote nodes.
    - Added BusTask (Priority 2) to asynchronously poll I2C bus at 10 Hz.
    - Implemented xNodeMutex to safely pass telemetry and commands between BusTask and ControlTask.
    - Added hardware node health tracking (is_online flag) based on I2C ACK/NACK.
2026-07-13 refactor: object-oriented ZoneCtrl and Multi-Zone Brain
    - Encapsulated duty cycles and requested loads into ZoneCtrl struct.
    - Purged legacy g_heater_duty/g_fan_duty globals.
    - Refactored ControlTask to iterate over NUM_REMOTE_NODES.
    - Wired FSM to shared RTOS memory instead of local ADC polling.
    - Injected FR_NODE_OFFLINE fault gracefully when ATmegas disconnect.
2026-07-15 P2 bring-up WIP: bare-metal TWI slave, LED debug builds, jig; node still offline
2026-07-15 P2 debug v3: UART status stream + parser; first capture = corrupted channel
    [dump.txt]
2026-07-20 P2 bring-up CLOSED: 9/9 clean poll cycles on wire; races fixed; node ONLINE with live telemetry
    [dump.txt]
2026-07-20 Sensor chain v2: matched-R25 differential (ADC1-ADC0, 10x)
    - Contract A RATIFIED: wire adc_raw = signed counts + 512, unsigned u16;
    producer zone1/Zone1.c, consumer node_counts_to_rntc() - both sides
    in this commit
    - Count-domain decode, rail cancels exactly (bench: -41cnt=7.1R=34C)
    - Count-domain fault thresholds: short<-140, open>+400 (anchors:
    short=-151, 80C=-126, 0C=+267, open=+511sat)
    - BusTask: vTaskDelay + documented TWINT re-arm gap (~40-node ceiling)
    - Removed dead P1 path: adc_to_rntc_5v, hadc1 extern, xAdcMutex
    - Hardware-verified: ambient reads 34C, pinch responds, NTC-open trips
    and recovers
    [Zone1.c, thermal_app.c, thermal_app.h]
2026-07-22 fix(thermal_app): static zone-name table instead of strdup
    strdup is POSIX, not C11. With no declaration in scope the compiler assumed it
    returns int and that int got assigned to a char* - works on a 32-bit target by
    luck. Also a heap allocation at init on a part with no allocator worth using.
    Three fixed strings, so a static table of literals does the job. Turned up when
    I compiled the file for the host, where the declaration is genuinely missing.
    [thermal_app.c]
2026-07-23 fix(parser): rework dump handling, framing and CSV export
    Started as a MemoryError, turned into five bugs.
    The crash: a 20 s log paired with events from a 1858 s run put state rectangles
    off the axes, and bbox_inches='tight' sized the canvas to fit them - 111k px
    wide. The renderer failed but the data was the bug: run1.bin was 768 bytes, the
    log dumped with the events byte count, so 21 of 2048 entries. Added
    validate_events(), clamp_span(), a bbox ceiling, and a size check that names
    this case with the right gdb command.
    --no-plot never worked - use('Agg') ran after pyplot was imported. Renamed to
    --no-show, added --csv-only.
    The denied-load hatch was drawn wherever heater_duty < heater_r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
2026-07-24 chore(scripts): regenerate run figures with the reworked parser
    Same dump, new renderer. The overview temperature axis is 27-36 C instead of
    25-50, the denied-load hatch now only covers actual throttling, and the KPI
    banner puts handover step and mean error at the top.
    [dump.txt, run1.csv, run1_events.csv]
2026-07-27 test: run pid.c on the host under Unity
    pid.c has no HAL dependencies so it builds for the host unchanged. Seven tests
    against the real source file, 0.00 s:
    init clears state, alpha == Ts/(tau_f+Ts), reverse-acting sign, output
    clamped, integrator freezes while saturated, recovers after, no derivative
    kick on a setpoint step.
    The saturation pair is the point of the exercise - on hardware you infer
    anti-windup from a plot, here it's asserted.
    Noted but not fixed: pid.c has file-scope out_min/out_max that nothing reads.
    [test_pid.c]
2026-07-28 test: fake headers for the HAL and FreeRTOS
    Cut at the HAL boundary rather than behind a new porting layer - refactoring
    untested code first is the wrong order.
    Peripheral handles are opaque structs: thermal_app.c declares them extern and
    only ever passes their addresses around, never reads a field, so an empty type
    is a faithful stand-in. portYIELD_FROM_ISR is a no-op macro - there is no
    preemption to yield to.
    [queue.h, semphr.h, task.h]
2026-07-29 test: fake the clock, owned by the test
    Time only moves when a test says so, which makes runs deterministic and lets a
    30-minute scenario finish in milliseconds. HAL_Delay advances the counter
    instead of blocking, so timestamps in the log stay consistent with what the
    target would have produced - on hardware that delay really does pass.
    HAL_TIM_Base_Start_IT is a no-op: the test is the timer, it calls the ISR
    directly whenever it wants a control cycle.
2026-07-30 test: fake tasks, mutexes and the event queue
    tasks recorded, never started. The bodies are for(;;) loops; the test
    calls the control logic directly, so starting them would hang.
    mutexes always succeed, take/give counted. One thread means nothing to
    arbitrate, so that's accurate rather than lazy - and an unbalanced
    pair (a deadlock on target) becomes a number a test can assert on.
    queue real ring buffer. ControlTask 'continue's on a failed receive, so a
    queue that never delivers would spin forever.
    Handles are 1-based because the firmware checks them against NULL.
    xQueueReceive returns pdFALSE on empty rather than emulating portMAX_D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
    [fake_rtos.c]
2026-08-01 test: scriptable I2C nodes
    The test decides which nodes answer and what they report, and can read back the
    last command sent to each. A node that is not present NAKs, which the real HAL
    reports as HAL_ERROR and BusTask turns into is_online = 0.
    Bus timing, arbitration and clock stretching are not modelled - the firmware
    only ever branches on HAL_OK versus not.
2026-08-02 build: wire the fakes in - thermal_app.c links on the host
    test/fakes leads the include path, which is the whole mechanism: #include
    "FreeRTOS.h" picks up the fake because that directory is searched first.
    PUBLIC propagates the ordering to anything linking the library, so the firmware
    finds the same headers without repeating them.
    The firmware is compiled from Core/Src, not copied.
2026-08-03 test: I2C node-offline handling
    Seven tests: scan finds only present nodes, an absent node goes offline, one
    node dropping doesn't disturb the others, offline drives the zone to
    FR_NODE_OFFLINE, mutexes balance on both the normal and the early-exit path,
    init leaves a usable queue behind.
    BusTask and ControlTask are static so a test can't call them; bus_poll_once()
    reproduces the inner loop by hand. Duplication, and I'd rather fix it by
    splitting for(;;) from the body - but that's a refactor and tests come first.
    [test_nodes.c]
2026-08-05 test: FOPDT plant from the bench measurements
    K=8.2 C/duty, tau=111 s, theta=10 s - the constants identified from the step
    test on real hardware - stepped at the 1 s control period.
    Dead time is a shift register of past duty commands, not an average: the delay
    is what makes the loop overshoot, so averaging it away would hide the thing
    worth testing.
    Temperature leaves as raw counts, not degrees. The inverse NTC chain here
    reproduces the bench anchors independently: 0 C -> 267 counts, 25 C -> 0.
    [plant.c, plant.h]
2026-08-07 test: close the loop against the plant
    Six cases: dead time present, open-loop gain matches identification, one tau
    reaches 63%, loop regulates, noise doesn't destabilise, hard cutoff fires above
    MAX_SAFE_TEMP_C. 2400 simulated seconds in under 10 ms.
    Two things fell out while writing these:
    detect_fault() trips FR_FAN_OPEN at power-up if the tach reads under 300 rpm.
    The bench fan free-runs off its own rail so it never does, and the sim models
    that now - but there's no allowance for a fan starting from rest.
    My first regulation test passed with the fan at zero all run: 25 + 8.2*0.6 =
    29.92 against a 30 C setpoint, so the plant settled on its own and the
    controller was never exercised. Lo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
    [test_loop.c]
2026-08-08 fix(test): feed the controller decoded counts, not the plant temperature
    The loop was passing plant_temp_c() straight into Zone_Tick. Noisy counts were
    generated, put on the wire and decoded - then used only by detect_fault(). The
    PID saw a perfect measurement, so the clean and noisy runs came out identical
    and the noise test asserted nothing.
    temp_c now comes from decode_counts_to_celsius(decoded). The noisy run shows
    3.5x the fan jitter and 2.5x the temperature ripple, and the quantisation
    staircase shows up in both - one count is about 0.17 C near the setpoint, which
    the old path hid.
    Two assertions so it can't come back: a bounded-hunting check that fails if the
    fan is perfectly steady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
    [plant.c, test_loop.c]
2026-08-09 docs: host test harness, and close out the bring-up log
    The bring-up section still said 'in progress' months after c301bca closed it
    with 9/9 clean poll cycles on the wire - that undersold finished work to anyone
    reading the repo.
    Adds the harness: 21 tests across three binaries, the closed-loop figure, and
    the bugs it found - the fan-floor assumption in detect_fault, and two of my own
    test bugs where a green suite was asserting nothing.
2026-08-09 docs: re-render run figures from the differential sensor chain
    The figures in docs/ were from July, before the sensor rework - single-ended
    era, and the count-domain fault thresholds did not exist yet. The README has
    been describing one thing and showing another.
    Re-rendered from the current dump with the current parser: the KPI banner is
    computed from the data, the fault zoom shows the node-offline window with
    telemetry blanked rather than held, and vnode is labelled as reconstructed
    from counts because that is what it is.
2026-08-09 test: replay the recorded run in simulation, rendered by the same parser
    test_sim_run writes the firmware's own black-box binary layout, so
    parse_struct_dump.py reads a simulated run exactly as it reads a dump pulled
    over SWD. Nothing in the reporting path knows the difference, which is the
    only way the comparison means anything.
    Same setpoints, same load steps, same differential ADC path - degC to counts
    to wire to decode, quantisation and +/-1 LSB jitter included - and the same
    node-offline fault that actually happened during bring-up.
    KPI hardware simulation
    run length 31:30 32:09
    mean |error| in PID 0.52 C 0.35 C
    throttle cycles 1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
    [plant.c, test_sim_run.c]
2026-08-09 fix(test): model the node's EMA - the sensor trace was dithering
    The simulated temperature dithered where the bench trace is a clean staircase,
    and the cause was a block missing from the model rather than a noise level set
    too high.
    zone1/Zone1.c samples the differential ADC at 100 Hz and runs
    adc_ema += 0.05*(raw - adc_ema) BEFORE rounding to a wire count. An EMA
    attenuates white noise by sqrt(a/(2-a)), so a=0.05 divides it by 6.2: +/-1 LSB
    of raw jitter becomes ~0.13 LSB at the output, which then mostly disappears in
    the rounding. The count only moves when the filtered value genuinely crosses a
    boundary. The simulator was injecting noise and quantising in the same breath,
    with nothing in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
    [test_sim_run.c]
